dhairyagada/PeltierTemperatureControl/README.md

# PeltierTemperatureControl

For more information on this project read the report [here](https://github.com/dhairyagada/PeltierTemperatureControl/blob/master/Report.pdf)
