dhairyagada/PeltierTemperatureControl/LTSpiceFiles/PWM_Filter.asc

C2: polcap; 470µ; V=20
D1: schottky; MBRS340
D2: schottky; MBRS340
D3: zener; BZX84C6V2L
D4: zener; BZX84C6V2L
L1: ind; 100µ; Ipk=3.5
L2: ind; 100µ; Ipk=3.5
M1: nmos; Si7336ADP
M2: nmos; Si7336ADP
R1: res; 3
V1: voltage; 12
V2: voltage; PULSE(0 5 0 0 0 50u 50u)
Named nets: 0
.tran 0 0.1 0 0.01
