dhairyagada/PeltierTemperatureControl/(commit log)

2018-04-18 PID Values Undecided
2018-04-20 Updated PID
2018-04-20 Serial Print Updated
2018-07-03 Added Arduino Code for LCD Hello World
2018-07-03 Set Temperature by Pot and Display on LCD
2018-07-05 Code for High Freq PWM on Pin 3
2018-07-05 Added LTSpice Circuit for LPF
2018-07-09 Added Relay Logic Code
